leehie1209/graduation_project_2025/README.md

30/12 mới xong code và chưa test bme và sdcard
sẽ test trong ngày hôm nay
--- đã fix xong bme, sdcard chưa test được

14/2 code I2C (2) kết hợp vs mqtt (1)
