leehie1209/graduation_project_2025/Hardware/307316013_135604272521302_7835246390251425891_n.png

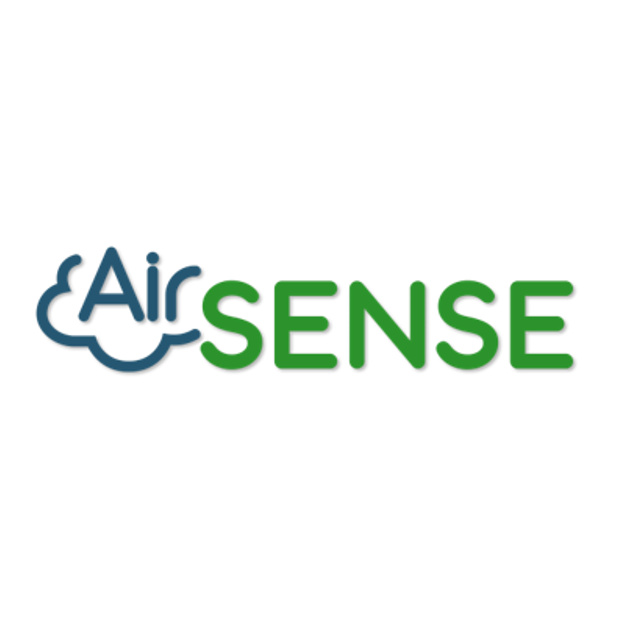
Hardware/307316013_135604272521302_7835246390251425891_n.png
