leehie1209/graduation_project_2025/Hardware/Source/2.1_BOM_exc.xlsx

Line # | Name | Description | Quantity | Link | Check | Column1
1 | USB - TypeC - 16P |  | 1
2 | LM1117 | 3V3 5V LDO, AMS1117, LDI1117 | 1 |  | X
3 | 10uH | 6.8-10uH | 1
4 | ESP32-WROOM-32 | Bluetooth, WiFi Transceiver Module 2.4GHz ~ 2.5GHz Surface Mount | 1 |  | X
5 | BQ24650 | BQ24650 Stand-Alone Synchronous Buck Battery Charge Controller for Solar Power With Maximum Power Point Tracking | 1 |  | X
6 | 1uF | C 0805 | 1
7 | 2.2uF | C 0805 | 1 |  |  | V
8 | 10uF | C 0805 | 5 |  |  | V
9 | 22pF | C 0805 | 1 |  |  | V
10 | 22uF 6.3V | C 0805 | 1 |  |  | V
11 | 100nF | C 0805 | 14 |  | X
12 | 100uF | C 0805 | 1
13 | 220pF | C 0805 | 1 |  |  | V
14 | 4.7uF 50V | C 1206 | 1 |  |  | V
15 | 10uF 50V | C 1206 | 3 |  |  | V
16 | 10uF | C 3216 | 2
17 | 100uF | C Tan 7343 | 2 |  |  | V
18 | INA226 | Current Sensing IC | 1 | https://shopee.vn/5PCS-INA226-INA226AIDGSR-MSOP-10-36V-16bit-TI-226-D%C3%B2ng-%C4%91i%E1%BB%87n-hai-chi%E1%BB%81u-M%C3%A0n-h%C3%ACnh-%C4%91i%E1%BB%87n-Chip-IC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 | X
19 | F1A | Fuse 5A | 1
20 | 10uH | Inductor | 1
21 | LED | LED Single colour Green and Red | 2 |  | X
22 | LED_S | LED Single colour Green and Red | 1 |  | X
23 | Testing | LED Single colour Green and Red | 1 |  | X
24 | AO4407A | MFET-ChP | 1 | https://shopee.vn/Set-10-Linh-Ki%E1%BB%87n-B%C3%A1n-D%E1%BA%ABn-AO4406-AO4407-AO4407A-AO4409-AO4423-AO4433-AO4435-AO4441-AO4354-AO4456-AO4466-AO4447A-SOP8-i.9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
25 | AON6508 | MFET-CHP | 2 |  | X
26 | MP1584 | MP1584, The wide 4.5V to 28V input range accommodates a variety of step-down applications, SOIC8E | 1
27 | 2SC1815 | NPN 600mW, ECB | 2
28 | 0R | R 0805 | 3 |  | X
29 | 1k | R 0805 | 9 |  | X
30 | 5k1 | R 0805 | 2 |  |  | V
31 | 10k | R 0805 | 9 |  | X
32 | 10R | R 0805 | 3
33 | 68.1k | R 0805 | 1 |  |  | V
34 | 100k | R 0805 | 1 |  | X
35 | 200k | R 0805 | 1 |  |  | v
36 | 220 | R 0805 | 2
37 | 1000 | R 0805 | 1 |  | X
38 | 0R | R 0805 1% | 1
39 | 24.9k | R 0805 1% | 1 |  |  | V
40 | 36k | R 0805 1% | 1
41 | 47k | R 0805 1% | 1 |  |  | v
42 | 100k | R 0805 1% | 1 |  |  | v
43 | 249k | R 0805 1% | 1 |  |  | v
44 | 499k | R 0805 1% | 2
45 | 2R | R 2512 | 1 |  |  | 2.2R
46 | 0.05R | R 2512 1% | 2 |  | X
47 | 1N5819 | Schottky Rectifiers | 1
48 | SS34-HF | Schottky Rectifiers | 1
49 | Diode Schottky | SS54 | 2
50 | SW-SMD | Switch | 3
51 | CH340C | USB to serial chip CH340 | 1
