leehie1209/graduation_project_2025/Hardware/Source/1_BQ24650_EVM/1.1_BQ24650_EVM_BOM.xlsx

Line # | Name | Description | Designator | Quantity
 | JP6 | WR-PHD 2.54 mm Angled Socket Header | C1 | 1
 | 10uF | Capacitor | C2, C3 | 2
 | 2.2uF | C_0805 | C4 | 1
 | 0.1uF | C_0805 | C5, C11, C15 | 3
 | 1uF | C_0805 | C6 | 1
 | 4.7uF | C_1206 | C7 | 1
 | 1uF | C_1206 | C8 | 1
 | 10uF | C_1206 | C9, C13 | 2
 | 10uF | C_0805 | C10, C12, C14 | 3
 | 0.47uF | C_0805 | C16 | 1
 | 22pF | C_0805 | C17 | 1
 | 1N5824 | SS54 Diode Schottky 5A 40V | D1 | 1
 | 1N5819 | S4 Diode Schottky 1A 40V | D2 | 1
 | Zenner 12V | generic zenner diode | D3, D4 | 2
 | F5A | Fuse 5A | F1, F2 | 2
 | 15uH | Inductor | L1 | 1
 | LED RGB SMD v1 |  | LED1 | 1
 | LED |  | LED2 | 1
 | SI7288 | Si7288 | Q1 | 1
 | Sud50p06 | Sud50p06 | Q2, Q3 | 2
 | 2R | R_2512 | R1, R2 | 2
 | 10R | R_0805 | R3, R9 | 2
 | NC | R_0805 | R4 | 1
 | 10k | R_0805 | R5, R14, R16 | 3
 | 0.05 | R_2512 | R6 | 1
 | 0R | R_0805 | R7, R10 | 2
 | DFN | R_0805 | R8 | 1
 | 1M | R_0805 | R11, R20 | 2
 | 100k | R_0805 | R12, R15, R18 | 3
 | 499k | R_0805 | R13, R17 | 2
 | 36k | R_0805 | R19 | 1
 | 1k | R_0805 | R21 | 1
 | 100R | R_0805 | R22 | 1
 | 115k | R_0805 | R23 | 1
 | SW | Switch button 4 pin | SW1 | 1
 | BQ24650 | BQ24650 Stand-Alone Synchronous Buck Battery Charge Controller for Solar Power With Maximum Power Point Tracking | U1 | 1
 | MAX8212 | Microprocessor Voltage Monitors with Programmable Voltage Detection | U2 | 1
