leehie1209/graduation_project_2025/Firmware/4_mode_test/README.md

đã có thể chuyển các mode với nhau 1 cách tương đối thuần thục
