leehie1209/graduation_project_2025/Hardware/Power.pdf

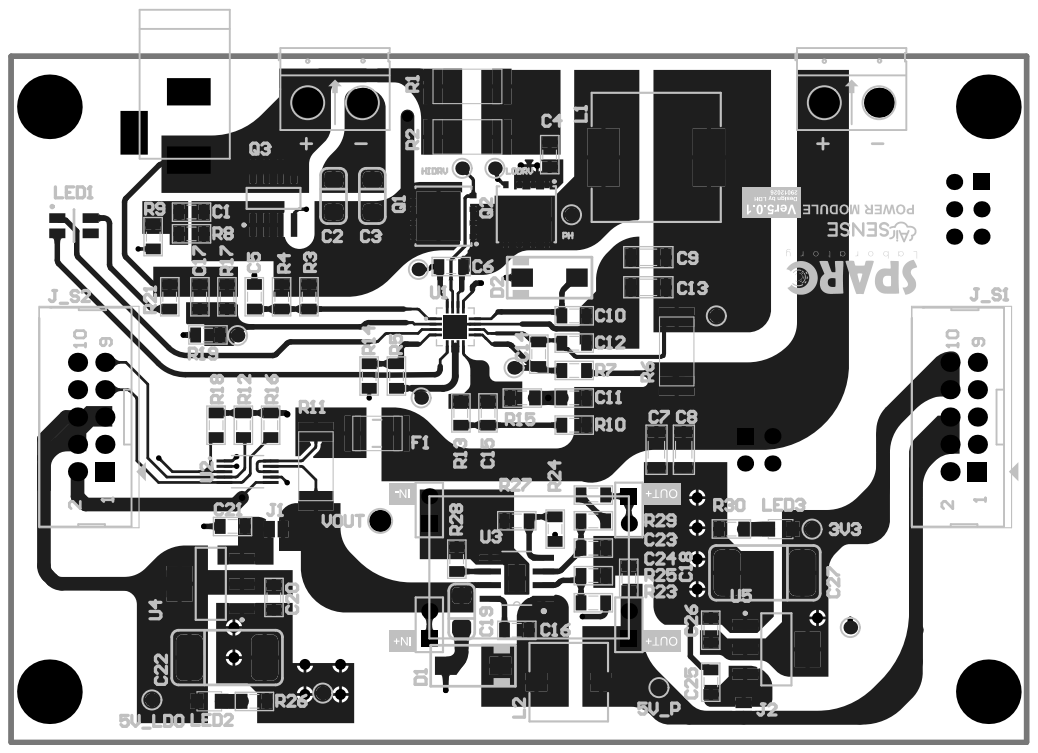
[picture p6: page 1]
