leehie1209/graduation_project_2025/Hardware/TI_EVM.pdf

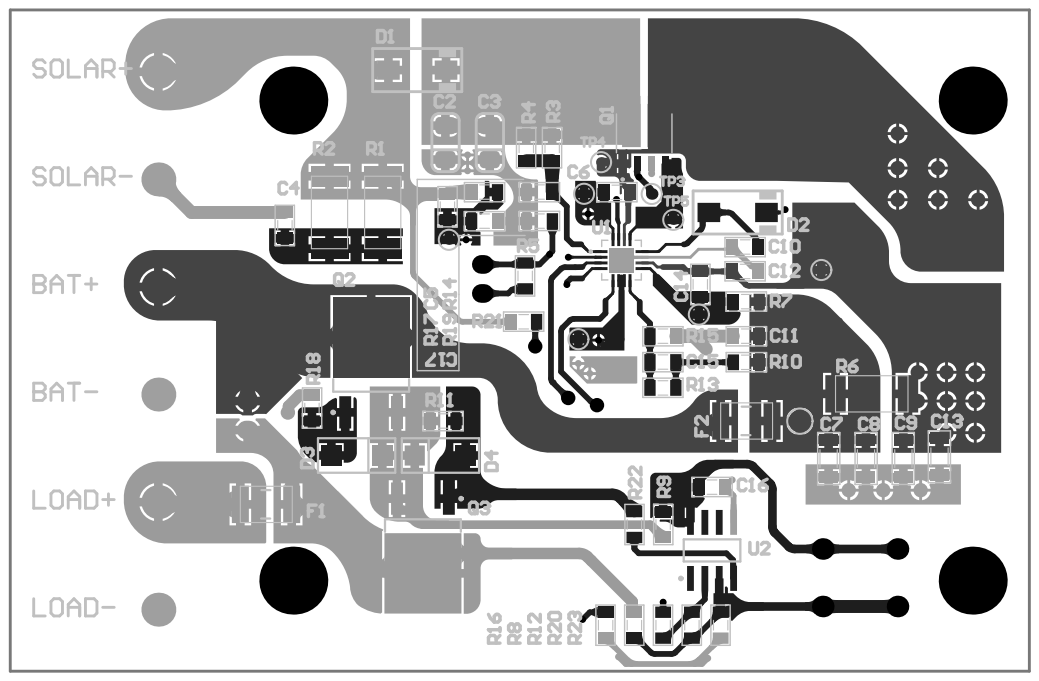
[picture p7: page 1]
