leehie1209/graduation_project_2025/Hardware/Source/1_BQ24650_EVM/Printing.pdf

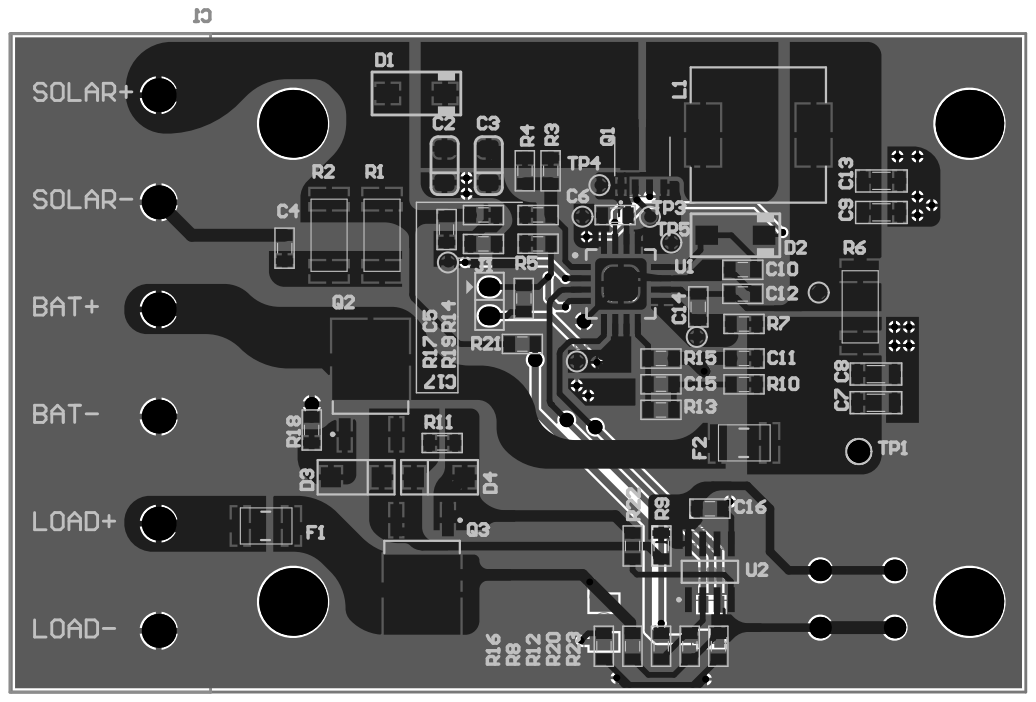
[picture p8: page 1]
