leehie1209/graduation_project_2025/Documents/HPA639A_sch.pdf

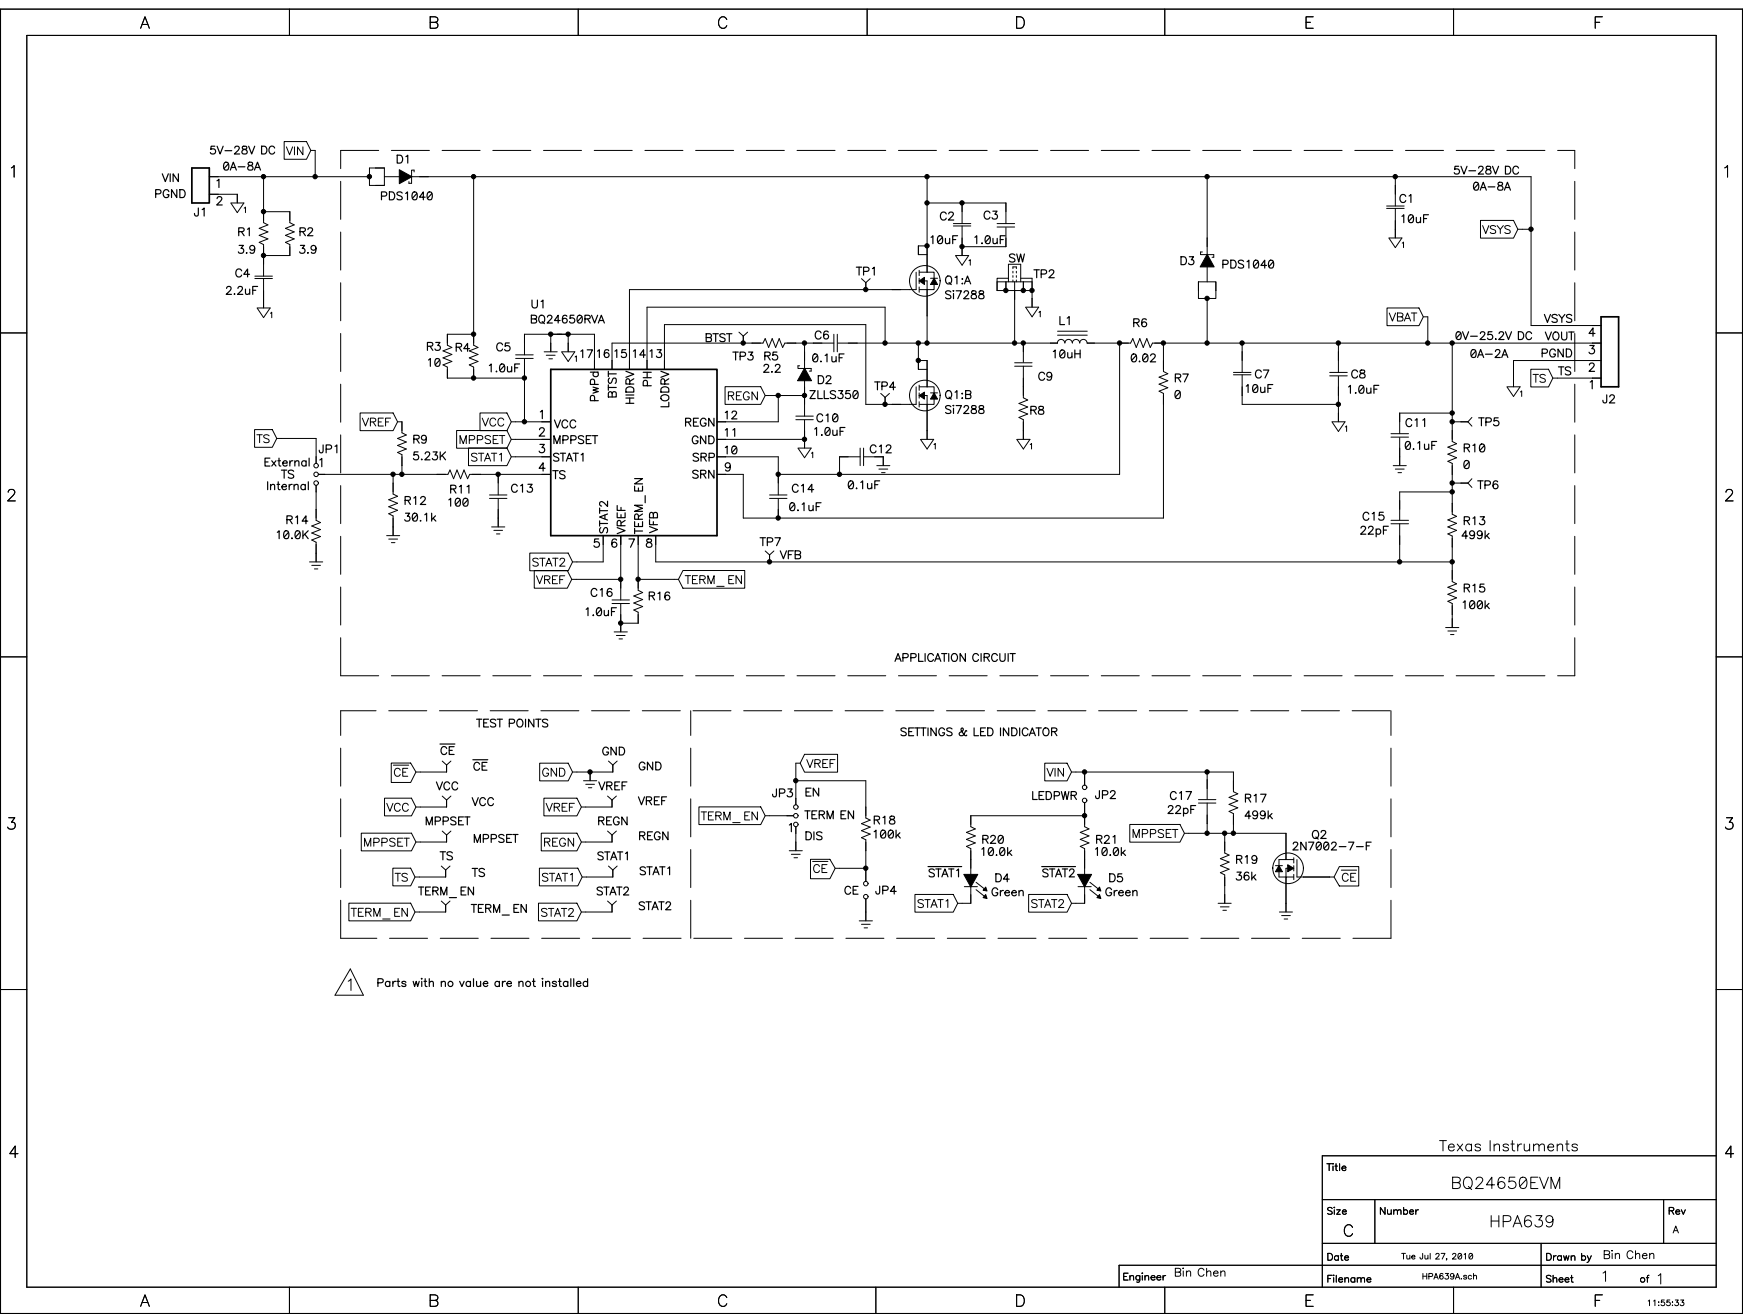
[picture p9: page 1]
