leehie1209/graduation_project_2025/(list of files, drawings)

Other design files:
Hardware/MCU/MCU/MCU1/MCU.SCHLIB
Hardware/MCU/MCU/MCU1/MCU_Module.PcbLib
Hardware/MCU/MCU/MCU.PrjPcb
Hardware/MCU/MCU/MCU.SchDoc
Hardware/MCU/MCU/MCU_Module.PcbDoc
Hardware/MCU/MCU/MCU_Src.SchDoc
Hardware/MCU/PCB_AirSENSE_v4.1.3.SchDoc
Hardware/Source/1_BQ24650_EVM/BQ24650_EVM.PrjPcb
Hardware/Source/1_BQ24650_EVM/TI_EVM.PcbDoc
Hardware/Source/1_BQ24650_EVM/TI_EVM.SchDoc
Hardware/Source/2_Grad_Source/Controller.SchDoc
Hardware/Source/2_Grad_Source/Grad_Source.PrjPcb
Hardware/Source/2_Grad_Source/Source.SchDoc
Hardware/Source/2_Grad_Source/Source_module.PcbDoc
Hardware/Source/3_BMS_Liion/3_BMS_Liion.PrjPcb
Hardware/Source/3_BMS_Liion/BMS_2S.PcbDoc
Hardware/Source/3_BMS_Liion/Li_ion_PRT-BL.SchDoc
Hardware/Source/4_Airsense_PowerSup/4_Airsense_PowerSup.PrjPcb
Hardware/Source/4_Airsense_PowerSup/Power_supply.SchDoc
Hardware/Source/4_Airsense_PowerSup/Power_supply_ver5.0.1.PcbDoc
