leehie1209/graduation_project_2025/Firmware/1_ina_mqtt/main/bme/bme280.h

#pragma once

#include <stdbool.h>

#ifdef __cplusplus
extern "C" {
#endif

typedef struct {
    float temperature;    // °C
    float humidity;       // %RH
    float pressure_hpa;   // hPa
    bool  valid;
} bme280_data_t;

/* Global data */
extern bme280_data_t g_bme280_data;

/* API */
void bme280_start_task(void);

#ifdef __cplusplus
}
#endif
