leehie1209/graduation_project_2025/Firmware/2_test_multiI2C/main/i2c/i2c_master_init.c

#include "driver/i2c.h"

#define I2C_MASTER_SCL_IO           27
#define I2C_MASTER_SDA_IO           26
#define I2C_MASTER_PORT             I2C_NUM_0
#define I2C_MASTER_FREQ_HZ          100000
#define I2C_MASTER_TX_BUF_DISABLE   0
#define I2C_MASTER_RX_BUF_DISABLE   0

esp_err_t i2c_master_init(void)
{
    i2c_config_t conf = {
        .mode = I2C_MODE_MASTER,
        .sda_io_num = I2C_MASTER_SDA_IO,
        .scl_io_num = I2C_MASTER_SCL_IO,
        .sda_pullup_en = GPIO_PULLUP_ENABLE,
        .scl_pullup_en = GPIO_PULLUP_ENABLE,
        .master.clk_speed = I2C_MASTER_FREQ_HZ,
    };

    ESP_ERROR_CHECK(i2c_param_config(I2C_MASTER_PORT, &conf));
    return i2c_driver_install(
        I2C_MASTER_PORT,
        I2C_MODE_MASTER,
        I2C_MASTER_RX_BUF_DISABLE,
        I2C_MASTER_TX_BUF_DISABLE,
        0
    );
}
