leehie1209/graduation_project_2025/(commit log)

2026-01-23 da xong cung, chua han, code them phan mode va chay duoc roi
    [MCU.PrjPcb, MCU.SchDoc, MCU_Module.PcbDoc, MCU_Src.SchDoc, Power_supply.SchDoc, Power_supply_ver5.0.0.PcbDoc, Source.SchDoc, TI_EVM.PcbDoc]
2026-02-14 14/2 hoan thanh code phu
    [4_Airsense_PowerSup.PrjPcb, Dung_luong.xlsx, Grad_Source.PrjPcb, MCU.PrjPcb, MCU.SchDoc, MCU_Module.PcbDoc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]
